Klink-Solutions/ch32v203-dev-board/docs/project-goals.md

# Project Goals

## Purpose

Create a useful dev board that tests core functionality of CHV32 for use in other projects

## Target users

Me 

Other tinkerer's 

## Non-goals
Wifi or blutooth

On chip sensors

## Constraints
### Timeline 
1 week design, 1 week build
### Budget
$60 USD including shipping and tax
