Klink-Solutions/ch32v203-dev-board/BOM.md

# CH32V203 Dev Board – bill of materials

<!-- Generated by Half Life from project cmuvdy6mq00vv01rknzwg5hz7. Edits here are overwritten on the next sync. -->
<!-- Generated: 2026-10-11T20:59:22.286Z -->

> [!NOTE]
> This parts list is mirrored from [Half Life](https://halflife.hackclub.com). Editing it here will not change the platform's copy, and the next sync overwrites this file.

| Week | Tier | Parts funding |
| --- | --- | --- |
| Week 1 | Tier 2 | $65.00 |

| Part | What it's for | Qty | Unit | Total | Vendor |
| --- | --- | --- | --- | --- | --- |
| [B3U-1000P](https://www.lcsc.com/product-detail/C231329.html) | Tactile Switch SPST 153gf 1.6mm SMD (SMT) Tab 3mm x 2.5mm Surface Mount | 10 | $0.19 | $1.90 | [LCSC](https://www.lcsc.com/product-detail/C231329.html) |
| [CGA0603X7R104K100JT](https://www.lcsc.com/product-detail/C36911391.html) | 100nF ±10% 10V Ceramic Capacitor X7R 0603 | 100 | $0.01 | $1.00 | [LCSC](https://www.lcsc.com/product-detail/C36911391.html) |
| [CGA0603X5R225K100JT](https://www.lcsc.com/product-detail/C7503508.html) | 2.2uF ±10% 10V Ceramic Capacitor X5R 0603 | 50 | $0.01 | $0.50 | [LCSC](https://www.lcsc.com/product-detail/C7503508.html) |
| [C0603C180F8HACAUTO](https://www.lcsc.com/product-detail/C3882391.html) | 18pF X8R ±1% 10V 0603 Ceramic Capacitors RoHS | 10 | $0.11 | $1.10 | [LCSC](https://www.lcsc.com/product-detail/C3882391.html) |
| [CL10A475KP8NNNC](https://www.lcsc.com/product-detail/C1705.html) | 4.7uF ±10% 10V Ceramic Capacitor X5R 0603 | 50 | $0.01 | $0.50 | [LCSC](https://www.lcsc.com/product-detail/C1705.html) |
| [PMEG3005EJ,115](https://www.lcsc.com/product-detail/C552853.html) | Diode 30V 500mA Surface Mount SOD-323F | 5 | $0.20 | $1.00 | [LCSC](https://www.lcsc.com/product-detail/C552853.html) |
| [WS2812B-B/W](https://www.lcsc.com/product-detail/C114586.html) | SMD5050-4P LED Addressable, Specialty | 5 | $0.10 | $0.50 | [LCSC](https://www.lcsc.com/product-detail/C114586.html) |
| [0603L050YR](https://www.lcsc.com/product-detail/C207015.html) | Polymeric PTC Resettable Fuse 6V 500mA Surface Mount 0603 | 5 | $0.19 | $0.95 | [LCSC](https://www.lcsc.com/product-detail/C207015.html) |
| [CH32V203K8T6](https://www.lcsc.com/product-detail/C5372188.html) | RISC-V 32 Bit 144MHz LQFP-32(7x7) Microcontrollers | 5 | $0.98 | $4.90 | [LCSC](https://www.lcsc.com/product-detail/C5372188.html) |
| [TYPE-C16PIN](https://www.lcsc.com/product-detail/C393939.html) | USB-C (USB TYPE-C) Receptacle Connector 16 Position Surface Mount, Right Angle | 10 | $0.06 | $0.60 | [LCSC](https://www.lcsc.com/product-detail/C393939.html) |
| [XY-S2B-PH-SM4-TB](https://www.lcsc.com/product-detail/C54582899.html) | Surface Mount, Right Angle PH 250V 2 1 2mm 2A 2P -25℃~+85℃ Tin Beige 1x2P SMD,P=2mm,Surface Mount,Right Angle Headers, Male Pins | 10 | $0.04 | $0.40 | [LCSC](https://www.lcsc.com/product-detail/C54582899.html) |
| [APT1608SURCK](https://www.lcsc.com/product-detail/C5875723.html) | Red 645nm LED Indication - Discrete 1.95V 0603 | 5 | $0.13 | $0.65 | [LCSC](https://www.lcsc.com/product-detail/C5875723.html) |
| [DMG2305UX-7](https://www.lcsc.com/product-detail/C5261054.html) | P-Channel 20V 5A 1.31W Surface Mount SOT-23 | 20 | $0.04 | $0.80 | [LCSC](https://www.lcsc.com/product-detail/C5261054.html) |
| [FRC0603J201 TS](https://www.lcsc.com/product-detail/C2907123.html) | 200Ω ±5% 100mW 0603 Thick Film Resistor | 100 | $0.00 | $0.00 | [LCSC](https://www.lcsc.com/product-detail/C2907123.html) |
| [FRC0603F5101TS](https://www.lcsc.com/product-detail/C2907044.html) | 5.1kΩ ±1% 100mW 0603 Thick Film Resistor | 100 | $0.00 | $0.00 | [LCSC](https://www.lcsc.com/product-detail/C2907044.html) |
| [FRC0603F1002TS](https://www.lcsc.com/product-detail/C2906982.html) | 10kΩ ±1% 100mW 0603 Thick Film Resistor | 100 | $0.00 | $0.00 | [LCSC](https://www.lcsc.com/product-detail/C2906982.html) |
| [FRC0603F1004TS](https://www.lcsc.com/product-detail/C2907003.html) | 1MΩ ±1% 100mW 0603 Thick Film Resistor | 100 | $0.00 | $0.00 | [LCSC](https://www.lcsc.com/product-detail/C2907003.html) |
| [TLV75733PDBVR](https://www.lcsc.com/product-detail/C485517.html) | 3.3V Positive Fixed SOT-23-5 Voltage Regulators - Linear, Low Drop Out (LDO) Regulators RoHS | 5 | $0.20 | $1.00 | [LCSC](https://www.lcsc.com/product-detail/C485517.html) |
| [MCP73831T-2ACI/OT](https://www.lcsc.com/product-detail/C424093.html) | 3.75V~6V 1 Lithium Battery 550mA SOT-23-5 Battery Chargers RoHS | 5 | $0.78 | $3.90 | [LCSC](https://www.lcsc.com/product-detail/C424093.html) |
| [NX5032GA-8MHZ-EXS00A-CG07039](https://www.lcsc.com/product-detail/C1986270.html) | Crystal 8MHz ±20ppm 18pF 300Ω SMD5032-2P | 5 | $0.49 | $2.45 | [LCSC](https://www.lcsc.com/product-detail/C1986270.html) |
| [PZ254-1-18-Z-8.5](https://www.lcsc.com/product-detail/C2894941.html) | Pin Header 18 Position 2.54mm Pitch Single Row Through Hole -40℃~+105℃ | 10 | $0.22 | $2.20 | [LCSC](https://www.lcsc.com/product-detail/C2894941.html) |
| [FRC0603F1003TS](https://www.lcsc.com/product-detail/C2907034.html) | RES 100K OHM 0603 | 100 | $0.00 | $0.00 | [LCSC](https://www.lcsc.com/product-detail/C2907034.html) |
| [FRC0603F4701TS](https://www.lcsc.com/product-detail/C2906980.html) | RES 4.7K OHM 0603 | 100 | $0.00 | $0.00 | [LCSC](https://www.lcsc.com/product-detail/C2906980.html) |
| [PCB](https://jlcpcb.com/) | Main board | 1 | $11.20 | $11.20 | [JLC PCB](https://jlcpcb.com/) |
| **Parts subtotal** | — | — | — | **$35.55** | — |
| **Tax & shipping** | — | — | — | **$20.33** | — |
| **Total** | — | — | — | **$55.88** | — |

$9.12 left of the tier's funding.
