Klink-Solutions/ch32v203-dev-board/bom/Klink_Board BOM.xls

Dev Board |  |  |  |  |  |  |  |  |  | LCSC BOM Quotation
 |  |  |  |  |  |  |  |  |  | BOM Date Created：12/10/26 01:48:28 |  |  |  | BOM Export Date: 12/10/26 02:14:12 |  |  |  | The matching result is a real-time query result, availability and prices may fluctuate. Backorder items are estimated prices for your reference, please submit "Create Quote" to get the real price. All information is provided "as is" and is subject to change without notice. Any use made of the information provided is without recourse to LCSC and at the user's risk.
 |  |  |  |  |  |  |  |  |  | EST TOTAL :$25.14 |  |  |  | Website：https://www.lcsc.com/bom | https://www.lcsc.com/bom | https://www.lcsc.com/bom | https://www.lcsc.com/bom
Uploaded data |  |  |  |  |  |  |  |  |  | LCSC Matching Results
LCSC# | Mfr. | Mrf# | Description | Package | Value | Customer Part Number | Quantity | Target Price(USD) | Target Lead Time(Business Days) | Mrf# | Mfr. | Order Qty. | Unit Price(USD) | Ext.Price(USD) | LCSC# | Package | Min | Mult | SPQ | Availability | Stock Status | Customer Notes | Description | Matched status | Product Link
 |  |  |  |  |  |  | 5 |  |  | WS2812B-B/W | Worldsemi | 5 | 0.1042 | 0.52 | C114586 | SMD5050-4P | 5 | 5 | 1000 | 354595 | In Stock |  | SMD5050-4P LED Addressable, Specialty | Exact Matches | https://www.lcsc.com/product-detail/C114586.html
 |  |  |  |  |  |  | 100 |  |  | FRC0603F1004TS | FOJAN | 100 | 0.0019 | 0.19 | C2907003 | 0603 | 100 | 100 | 5000 | 4930000 | In Stock |  | 1MΩ ±1% 100mW 0603 Thick Film Resistor | Exact Matches | https://www.lcsc.com/product-detail/C2907003.html
 |  |  |  |  |  |  | 100 |  |  | FRC0603F1002TS | FOJAN | 100 | 0.0020 | 0.20 | C2906982 | 0603 | 100 | 100 | 5000 | 1809200 | In Stock |  | 10kΩ ±1% 100mW 0603 Thick Film Resistor | Exact Matches | https://www.lcsc.com/product-detail/C2906982.html
 |  |  |  |  |  |  | 100 |  |  | FRC0603J201 TS | FOJAN | 100 | 0.0017 | 0.17 | C2907123 | 0603 | 100 | 100 | 5000 | 504700 | In Stock |  | 200Ω ±5% 100mW 0603 Thick Film Resistor | Exact Matches | https://www.lcsc.com/product-detail/C2907123.html
 |  |  |  |  |  |  | 200 |  |  | FRC0603F5101TS | FOJAN | 200 | 0.0020 | 0.40 | C2907044 | 0603 | 100 | 100 | 5000 | 5917000 | In Stock |  | 5.1kΩ ±1% 100mW 0603 Thick Film Resistor | Exact Matches | https://www.lcsc.com/product-detail/C2907044.html
 |  |  |  |  |  |  | 10 |  |  | C0603C180F8HACAUTO | KEMET | 10 | 0.1146 | 1.15 | C3882391 | 0603 | 5 | 5 | 4000 | 210 | In Stock |  | 18pF X8R ±1% 10V 0603 Ceramic Capacitors RoHS | Exact Matches | https://www.lcsc.com/product-detail/C3882391.html
 |  |  |  |  |  |  | 50 |  |  | CGA0603X5R225K100JT | HRE | 50 | 0.0113 | 0.57 | C7503508 | 0603 | 50 | 50 | 4000 | 61500 | In Stock |  | 2.2uF ±10% 10V Ceramic Capacitor X5R 0603 | Exact Matches | https://www.lcsc.com/product-detail/C7503508.html
 |  |  |  |  |  |  | 100 |  |  | CGA0603X7R104K100JT | HRE | 100 | 0.0053 | 0.53 | C36911391 | 0603 | 100 | 100 | 4000 | 284600 | In Stock |  | 100nF ±10% 10V Ceramic Capacitor X7R 0603 | Exact Matches | https://www.lcsc.com/product-detail/C36911391.html
 |  |  |  |  |  |  | 50 |  |  | CL10A475KP8NNNC | Samsung Electro-Mechanics | 50 | 0.0133 | 0.67 | C1705 | 0603 | 50 | 50 | 4000 | 1706550 | In Stock |  | 4.7uF ±10% 10V Ceramic Capacitor X5R 0603 | Exact Matches | https://www.lcsc.com/product-detail/C1705.html
 |  |  |  |  |  |  | 10 |  |  | TYPE-C16PIN | SHOU HAN | 10 | 0.0624 | 0.62 | C393939 | SMD | 10 | 10 | 1000 | 357210 | In Stock |  | USB-C (USB TYPE-C) Receptacle Connector 16 Position Surface Mount, Right Angle | Exact Matches | https://www.lcsc.com/product-detail/C393939.html
 |  |  |  |  |  |  | 5 |  |  | CH32V203K8T6 | WCH | 5 | 0.9843 | 4.92 | C5372188 | LQFP-32(7x7) | 1 | 1 | 250 | 671 | In Stock |  | RISC-V 32 Bit 144MHz LQFP-32(7x7) Microcontrollers | Exact Matches | https://www.lcsc.com/product-detail/C5372188.html
 |  |  |  |  |  |  | 10 |  |  | XY-S2B-PH-SM4-TB | XYECONN | 10 | 0.0419 | 0.42 | C54582899 | SMD,P=2mm,Surface Mount,Right Angle | 10 | 10 | 1000 | 1310 | In Stock |  | Surface Mount, Right Angle PH 250V 2 1 2mm 2A 2P -25℃~+85℃ Tin Beige 1x2P SMD,P=2mm,Surface Mount,Right Angle Headers, Male Pins | Exact Matches | https://www.lcsc.com/product-detail/C54582899.html
 |  |  |  |  |  |  | 5 |  |  | NX5032GA-8MHZ-EXS00A-CG07039 | NDK | 5 | 0.4898 | 2.45 | C1986270 | SMD5032-2P | 1 | 1 | 1000 | 3567 | In Stock |  | Crystal 8MHz ±20ppm 18pF 300Ω SMD5032-2P | Exact Matches | https://www.lcsc.com/product-detail/C1986270.html
 |  |  |  |  |  |  | 10 |  |  | B3U-1000P | OMRON | 10 | 0.1885 | 1.89 | C231329 | SMD,3x2.5mm | 5 | 5 | 3500 | 120370 | In Stock |  | Tactile Switch SPST 153gf 1.6mm SMD (SMT) Tab 3mm x 2.5mm Surface Mount | Exact Matches | https://www.lcsc.com/product-detail/C231329.html
 |  |  |  |  |  |  | 5 |  |  | PMEG3005EJ,115 | Nexperia | 5 | 0.1968 | 0.98 | C552853 | SOD-323F | 5 | 5 | 3000 | 4515 | In Stock |  | Diode 30V 500mA Surface Mount SOD-323F | Exact Matches | https://www.lcsc.com/product-detail/C552853.html
 |  |  |  |  |  |  | 5 |  |  | APT1608SURCK | Kingbright | 5 | 0.1264 | 0.63 | C5875723 | 0603 | 5 | 5 | 2000 | 5915 | In Stock |  | Red 645nm LED Indication - Discrete 1.95V 0603 | Exact Matches | https://www.lcsc.com/product-detail/C5875723.html
 |  |  |  |  |  |  | 20 |  |  | DMG2305UX-7 | HXY MOSFET | 20 | 0.0376 | 0.75 | C5261054 | SOT-23 | 20 | 20 | 3000 | 22360 | In Stock |  | P-Channel 20V 5A 1.31W Surface Mount SOT-23 | Exact Matches | https://www.lcsc.com/product-detail/C5261054.html
 |  |  |  |  |  |  | 5 |  |  | 0603L050YR | Littelfuse | 5 | 0.1940 | 0.97 | C207015 | 0603 | 5 | 5 | 4000 | 4990 | In Stock |  | Polymeric PTC Resettable Fuse 6V 500mA Surface Mount 0603 | Exact Matches | https://www.lcsc.com/product-detail/C207015.html
 |  |  |  |  |  |  | 5 |  |  | TLV75733PDBVR | TI | 5 | 0.2014 | 1.01 | C485517 | SOT-23-5 | 5 | 5 | 3000 | 81845 | In Stock |  | 3.3V Positive Fixed SOT-23-5 Voltage Regulators - Linear, Low Drop Out (LDO) Regulators RoHS | Exact Matches | https://www.lcsc.com/product-detail/C485517.html
 |  |  |  |  |  |  | 5 |  |  | MCP73831T-2ACI/OT | MICROCHIP | 5 | 0.7761 | 3.88 | C424093 | SOT-23-5 | 1 | 1 | 3000 | 13088 | In Stock |  | 3.75V~6V 1 Lithium Battery 550mA SOT-23-5 Battery Chargers RoHS | Exact Matches | https://www.lcsc.com/product-detail/C424093.html
 |  |  |  |  |  |  | 10 |  |  | -(The data has been deleted.) | - | - | - | - | - | - | - | - | - | - | - | - | - | -
 |  |  |  |  |  |  | 10 |  |  | PZ254-1-18-Z-8.5 | HCTL | 10 | 0.2216 | 2.22 | C2894941 | Through Hole,P=2.54mm | 5 | 5 | 500 | 1975 | In Stock |  | Pin Header 18 Position 2.54mm Pitch Single Row Through Hole -40℃~+105℃ | Exact Matches | https://www.lcsc.com/product-detail/C2894941.html
