Klink-Solutions/ch32v203-dev-board/pcb/Klink_Dev_Board.step

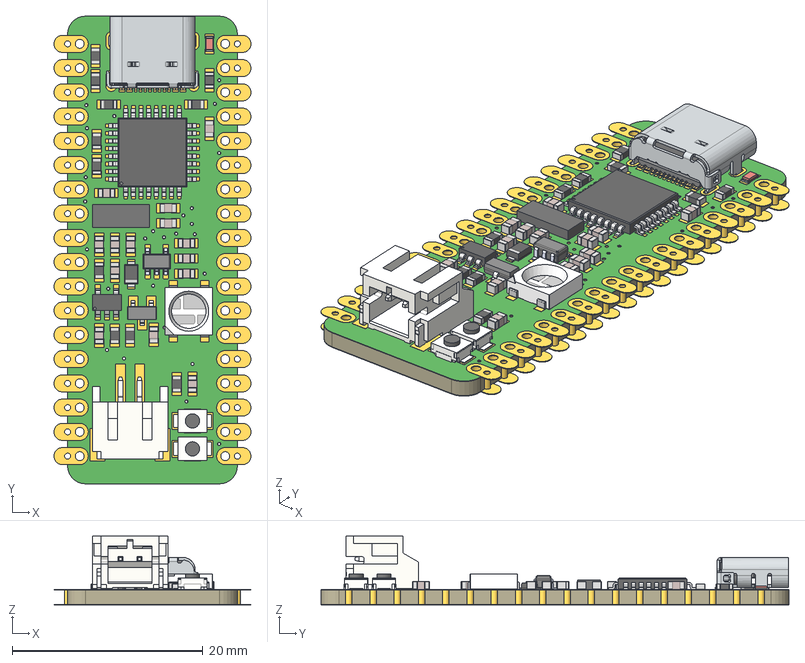
[picture p1: CAD file, 2026-10-11]
pcb/Klink_Dev_Board.step
20.6 x 49.0 x 7.22 mm
Board
1-copper
64-copper
1-soldermask
64-soldermask
SOT-23-5
9216932.f3d x 14
16357024.f3d
SODFL2513X70 (1)
SOT95P280X110-5 v1
5576557.f3d x 10
158819.f3d
LEDC1608X39N_R
LQFP32-7X7
629722000214_Housing
629722000214_Pin1_Top
629722000214_Pin4_Bottom
629722000214_Pin4_Top x 2
629722000214_Pin1_Bottom
629722000214_Pin3_Bottom
629722000214_Pin3_Top
629722000214_Pin2_Top
629722000214_Pin2_Bottom
629722000214_Pin1_Top_mir
629722000214_Pin1_Bottom_mir
629722000214_Pin2_Top_mir
629722000214_Pin2_Bottom_mir
629722000214_Pin3_Top_mir
629722000214_Pin3_Bottom_mir
629722000214_Pin4_Bottom_mir
629722000214_Shielding2
629722000214_Shielding
LED SMD 5050 RGB v22
B3U-1000P(M) v3 x 2
NX5032
S2B-PH-SM4-TB v1
