Klink-Solutions/ch32v203-dev-board/pcb/Klink_Dev_Board.brd

## EAGLE design pcb/Klink_Dev_Board.brd (2026-10-11)

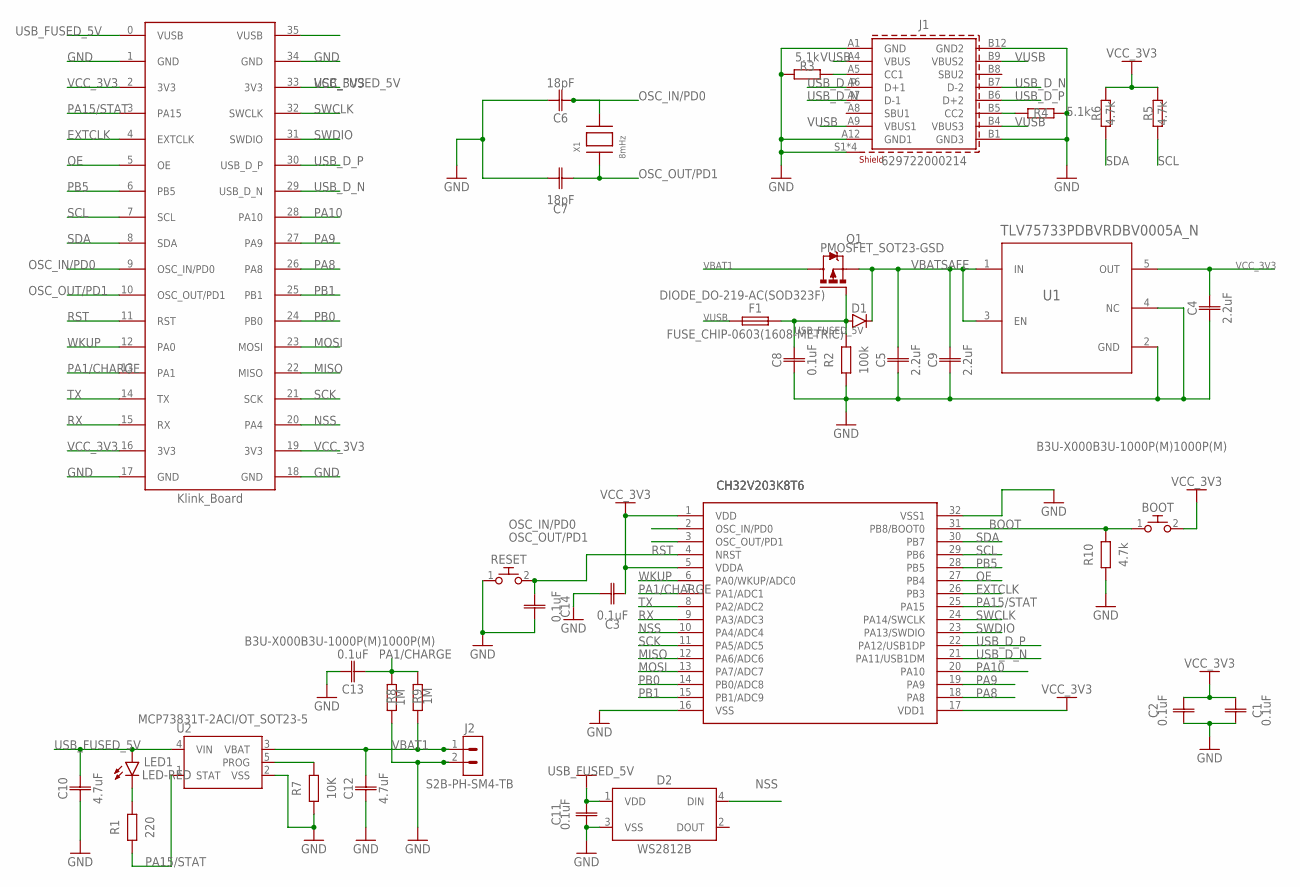
[picture p2: schematic Dev_Board_Schematic.sch]

Parts:
BOOT: B3U-X000B3U-1000P(M)1000P(M); B3U-1000P(M)
C1, C2, C3, C8, C11, C13, C14: 0.1uF; CAPC1608X85
C4, C5, C9: 2.2uF; CAPC1608X85
C6, C7: 18pF; CAPC1608X85
C10, C12: 4.7uF; CAPC1608X85
D1: DIODE_DO-219-AC(SOD323F); SODFL2513X70
D2: WS2812B
F1: FUSE_CHIP-0603(1608-METRIC); FUSC1608X60N
IC1: CH32V203K8T6LQFP32; LQFP32-7X7
J1: 629722000214
J2: S2B-PH-SM4-TB
LED1: LED-RED; LEDC1608X39N_R
Q1: PMOSFET_SOT23-GSD; SOT23
R1: 220; RESC1608X60
R2: 100k; RESC1608X60
R3, R4: 5.1k; RESC1608X60
R5, R6, R10: 4.7k; RESC1608X60
R7: 10K; RESC1608X60
R8, R9: 1M; RESC1608X60
RESET: B3U-X000B3U-1000P(M)1000P(M); B3U-1000P(M)
U1: TLV75733PDBVRDBV0005A_N; SOT-23-5
U2: MCP73831T-2ACI/OT_SOT23-5; SOT95P280X110-5
U$1: KLINK_BAORDHYBRID_THROUGH_HOLE; HYBRID_THROUGH_HOLE
X1: 8mHz; NX5032

Connections:
BOOT: BOOT.1, IC1.31 (PB8/BOOT0), R10.2
EXTCLK: IC1.26 (PB3), U$1.4 (EXTCLK)
GND: C1.1, C2.1, C3.2, C4.1, C5.1, C6.2, C7.2, C8.1, C9.1, C10.2, C11.1, C12.2, C13.1, C14.2, D2.3 (VSS), IC1.16 (VSS), IC1.32 (VSS1), J1.A1 (GND), J1.A12 (GND1), J1.B1 (GND3), J1.B12 (GND2), J1.S1 (SHIELD), J1.S2 (SHIELD), J1.S3 (SHIELD), J1.S4 (SHIELD), J2.2, R2.1, R3.2, R4.1, R7.1, R8.1, R10.1, RESET.1, U1.2 (GND), U1.4 (NC), U2.2 (VSS), U$1.1 (GND), U$1.17 (GND), U$1.18 (GND), U$1.34 (GND)
MISO: IC1.12 (PA6/ADC6), U$1.22 (MISO)
MOSI: IC1.13 (PA7/ADC7), U$1.23 (MOSI)
unnamed: J1.B5 (CC2), R4.2
unnamed: J1.A5 (CC1), R3.1
unnamed: LED1.1 (C), R1.2
NSS: D2.4 (DIN), IC1.10 (PA4/ADC4), U$1.20 (PA4)
OE: IC1.27 (PB4), U$1.5 (OE)
OSC_IN/PD0: C6.1, IC1.2 (OSC_IN/PD0), U$1.9 (OSC_IN/PD0), X1.P$2
OSC_OUT/PD1: C7.1, IC1.3 (OSC_OUT/PD1), U$1.10 (OSC_OUT/PD1), X1.P$1
PA1/CHARGE: C13.2, IC1.7 (PA1/ADC1), R8.2, R9.2, U$1.13 (PA1)
PA8: IC1.18 (PA8), U$1.26 (PA8)
PA9: IC1.19 (PA9), U$1.27 (PA9)
PA10: IC1.20 (PA10), U$1.28 (PA10)
PA15/STAT: IC1.25 (PA15), R1.1, U2.1 (STAT), U$1.3 (PA15)
PB0: IC1.14 (PB0/ADC8), U$1.24 (PB0)
PB1: IC1.15 (PB1/ADC9), U$1.25 (PB1)
PB5: IC1.28 (PB5), U$1.6 (PB5)
PROG: R7.2, U2.5 (PROG)
RST: C14.1, IC1.4 (NRST), RESET.2, U$1.11 (RST)
RX: IC1.9 (PA3/ADC3), U$1.15 (RX)
SCK: IC1.11 (PA5/ADC5), U$1.21 (SCK)
SCL: IC1.29 (PB6), R5.1, U$1.7 (SCL)
SDA: IC1.30 (PB7), R6.1, U$1.8 (SDA)
SWCLK: IC1.24 (PA14/SWCLK), U$1.32 (SWCLK)
SWDIO: IC1.23 (PA13/SWDIO), U$1.31 (SWDIO)
TX: IC1.8 (PA2/ADC2), U$1.14 (TX)
USB_D_N: IC1.21 (PA11/USB1DM), J1.A7 (D-1), J1.B7 (D-2), U$1.29 (USB_D_N)
USB_D_P: IC1.22 (PA12/USB1DP), J1.A6 (D+1), J1.B6 (D+2), U$1.30 (USB_D_P)
USB_FUSED_5V: C8.2, C10.1, C11.2, D1.2 (A), D2.1 (VDD), F1.2, LED1.2 (A), Q1.1 (G), R2.2, U2.4 (VIN), U$1.0 (VUSB), U$1.35 (VUSB)
VBAT1: C12.1, J2.1, Q1.3 (D), R9.1, U2.3 (VBAT)
VBATSAFE: C5.2, C9.2, D1.1 (C), Q1.2 (S), U1.1 (IN), U1.3 (EN)
VCC_3V3: BOOT.2, C1.2, C2.2, C3.1, C4.2, IC1.1 (VDD), IC1.5 (VDDA), IC1.17 (VDD1), R5.2, R6.2, U1.5 (OUT), U$1.2 (3V3), U$1.16 (3V3), U$1.19 (3V3), U$1.33 (3V3)
VUSB: F1.1, J1.A4 (VBUS), J1.A9 (VBUS1), J1.B4 (VBUS3), J1.B9 (VBUS2)
WKUP: IC1.6 (PA0/WKUP/ADC0), U$1.12 (PA0)

Notes on the sheet:
CH32V203K8T6

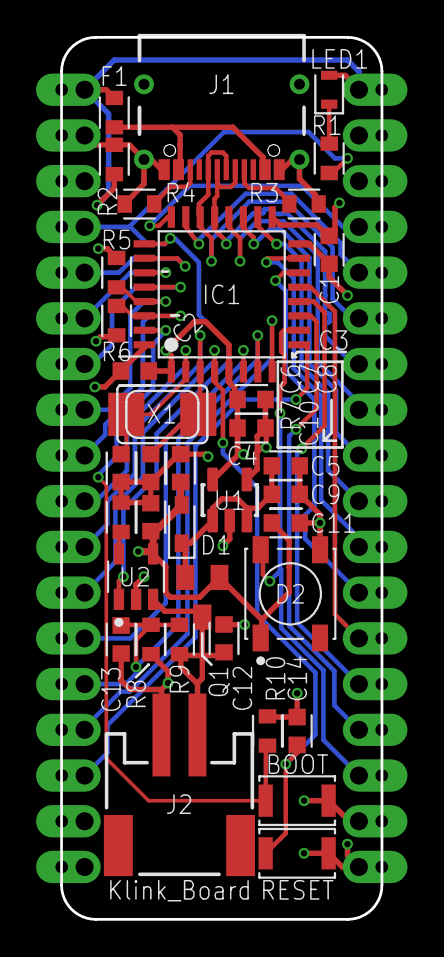
[picture p3: board Klink_Dev_Board.brd from above]

Board: 4 copper layers, 17.8 x 49.0 mm, 38 parts (0 on the bottom side), 37 nets.
