Klink-Solutions/ch32v203-dev-board/JOURNAL.md

# CH32V203 Dev Board – devlog

<!-- Generated by Half Life from project cmuvdy6mq00vv01rknzwg5hz7. Edits here are overwritten on the next sync. -->
<!-- Generated: 2026-10-11T19:00:41.574Z -->

> [!NOTE]
> This devlog is mirrored from [Half Life](https://halflife.hackclub.com). Editing it here will not change the platform's copy, and the next sync overwrites this file.

> A ultra low power XIAO ish  sized development board to based on the WCH CH32V203K8T6

| Week | Tier | Hours logged | Entries |
| --- | --- | --- | --- |
| Week 1 | Tier 2 | 22.43h | 4 |

## Contents

1. [2026-10-08 – At the start of this project I wanted to not only  better my github skills but also learn the proper development cycle of a project . This meant that I started my research with simple goals based on m](#2026-10-08-at-the-start-of-this-project-i-wanted-to-not-only)
2. [2026-10-09 – Having a full day to work on this project before the end of the week I got to work turning my design rules into a product! This starts of course with finding parts to match my goals. First a suitable](#2026-10-09-having-a-full-day-to-work-on-this-project-before-)
3. [2026-10-10 – Work session](#2026-10-10-work-session)
4. [2026-10-11 – Well the board was done just needed a few final tweaks to make it more useable as a dev board ( with the limited space I have I still need to see what pin is what on the back of the board](#2026-10-11-well-the-board-was-done-just-needed-a-few-final-t)

## Design

### 2026-10-08 – At the start of this project I wanted to not only  better my github skills but also learn the proper development cycle of a project . This meant that I started my research with simple goals based on m

**6h**

At the start of this project I wanted to not only  better my github skills but also learn the proper development cycle of a project . This meant that I started my research with simple goals based on my original project idea and constraints I knew I wanted.


From there I took time to look into what my own goals meant - from the requirements of the MCU that I chose to the specifics of other Xiao boards and around that I drew up some nice looking design requirements!

Sorted into sections of Electrical



To Mechanical



To Interface



And Manufacturing



Reading the long datasheet of my MCU did take a while and trying to understand it fully so I can make a project that works first try was paramount to me.

I really hope to be able to fit the entire battery circuitry on the board as well as i have put a bit of time into thinking that through as well but it remains to see if I have space for it once I choose the components finish the schematic and start laying out the board.

### 2026-10-09 – Having a full day to work on this project before the end of the week I got to work turning my design rules into a product! This starts of course with finding parts to match my goals. First a suitable

**8h**

Having a full day to work on this project before the end of the week I got to work turning my design rules into a product! This starts of course with finding parts to match my goals. First a suitable LDO :

Again trying to meet the low quiescent current requirements and size goals (we get back to this later today as my goals began to clash)
Then since I really wanted a on board battery charging solution I had to find a charging chip:

Taking guidance from the included typical application sheets and a bit of extra googling to add some safety and "idiotproofness" I ended up with a first schematic!

This is a later nce since my saving habits are so terrible but what this then showed me once I placed just the MCU and USBC on the board that I had no space...


looking back it should be obvious that my goals of hand solderability and small form factor were fundamentally clashing. I went down a small rabbit hole of making the charging components a " hat" to my board but I was still always gonna be lacking space- so I had to decide to adjust  my goals/requirements.



The new sizing I created as an independent component ( if I need my own dev board in future products) giving it 36 pins to allow the whole chip to be accessed and provide plenty of gnd and 3v3 for easy use on breadboards. The width is still the same as the xiao so call this the xiao long way :0

Then finally I got to sit and start routing( obviously the board is as small as can be to fit all 36 pins so this not easy- and also not done )





### 2026-10-10 – Work session

**4.43h**

[Timelapse](https://lookout.hackclub.com/api/media/aca7dc65-70c0-4bdd-8820-351ba0b10c95/video.mp4)

### 2026-10-11 – Well the board was done just needed a few final tweaks to make it more useable as a dev board ( with the limited space I have I still need to see what pin is what on the back of the board

**4h**

Well the board was done just needed a few final tweaks to make it more useable as a dev board ( with the limited space I have I still need to see what pin is what on the back of the board



(Obviously much cooler in black)

then I spent an unhealthy amount of time putting all the parts together in a BOM in Digykey- these guys are practically robbing me after i did the whole thing again in LCSC




Finally I took the finalized files, datasheets and BOM and organized them into my GitHub
