Klink-Solutions/ch32v203-dev-board/(commit log)

2026-10-06 Initial project scaffold
    Folder structure for PCB, BOM, datasheets, mechanical, firmware, test and
    manufacturing; README skeleton; requirements templates; task tracking system.
    Claude-Session: https://claude.ai/code/session_01A79Bgah72wHW76WjQAEh6y
    [bom.csv]
2026-10-06 Switch to Fusion workflow and GitHub Issues for task tracking
    Remove in-repo task folder; add issue forms (task, requirement, decision) and
    CONTRIBUTING.md; reword PCB docs around Fusion exports.
    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
2026-10-07 Draft design requirements rev 0.1 (#2)
    Requirements for electrical, mechanical, interfaces, firmware, cost and
    documentation from the 2026-10-07 design discussion; battery items pending
    review of the Bike Light circuit. Add JLCPCB 4-layer limits reference.
    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
2026-10-09 Update requirements to the fuse-limited current budget (#2)
    USB-powered 3V3 budget 250 mA while charging / 350 mA otherwise, charge current
    100 mA, fuse and cell-voltage wording, battery-powered 500 mA, new open
    questions. Fix README links to the moved docs.
    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
2026-10-11 Final BOM
    [Klink_Board BOM.xls]
2026-10-11 PCB File upload
    [Dev_Board_Schematic.sch, Klink_Dev_Board.brd]
2026-10-11 Update design requirements for K8T6, 49 mm board, 100 mA charging, RGB LED on USB, ESD decision (#2)
    Claude-Session: https://claude.ai/code/session_01TsguNHhs85BP5t93dgLnJ6
2026-10-11 Update requirements: through-hole JST, crystal DNP, close resolved questions (#2)
    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
2026-10-11 Sync CH32V203 Dev Board from Half Life
2026-10-11 Added BOM.csv
    [Klink_Dev_Board_BOM.csv]
2026-10-17 Revise README With BOM & better project definition
2026-10-21 Rename Klink_Dev_Board_BOM.csv to BOM.csv
    [BOM.csv]
