Klink-Solutions/ch32v203-dev-board/(notices)

Notices in the files:
parts and their libraries:
Wurth_Connectors_WR-USB: Copyright: Würth Elektronik
